Emajack512/stm32-Esp32-Oscilloscope/media/02 Oscilloscope.jpg

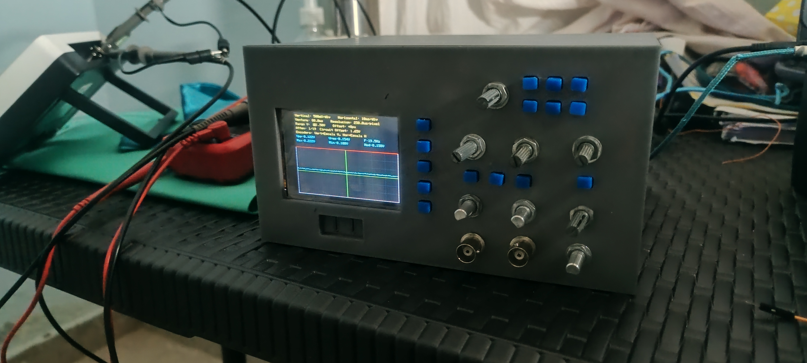
media/02 Oscilloscope.jpg
