Emajack512/stm32-Esp32-Oscilloscope/media/03 Oscilloscope.png

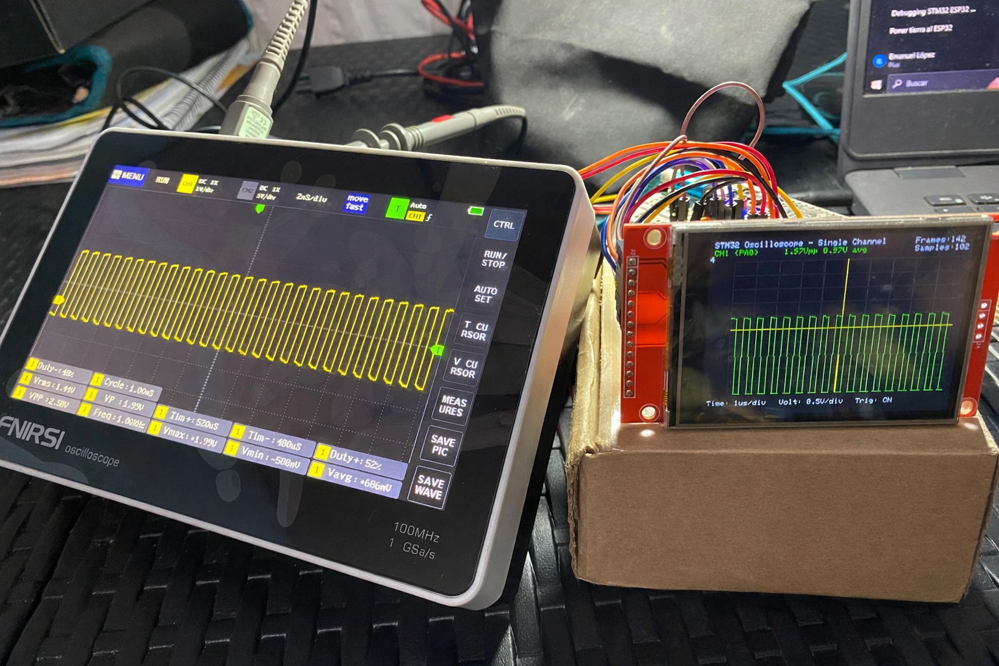
media/03 Oscilloscope.png
