Emajack512/stm32-Esp32-Oscilloscope/hardware/Diagram PCB oscilloscope.png

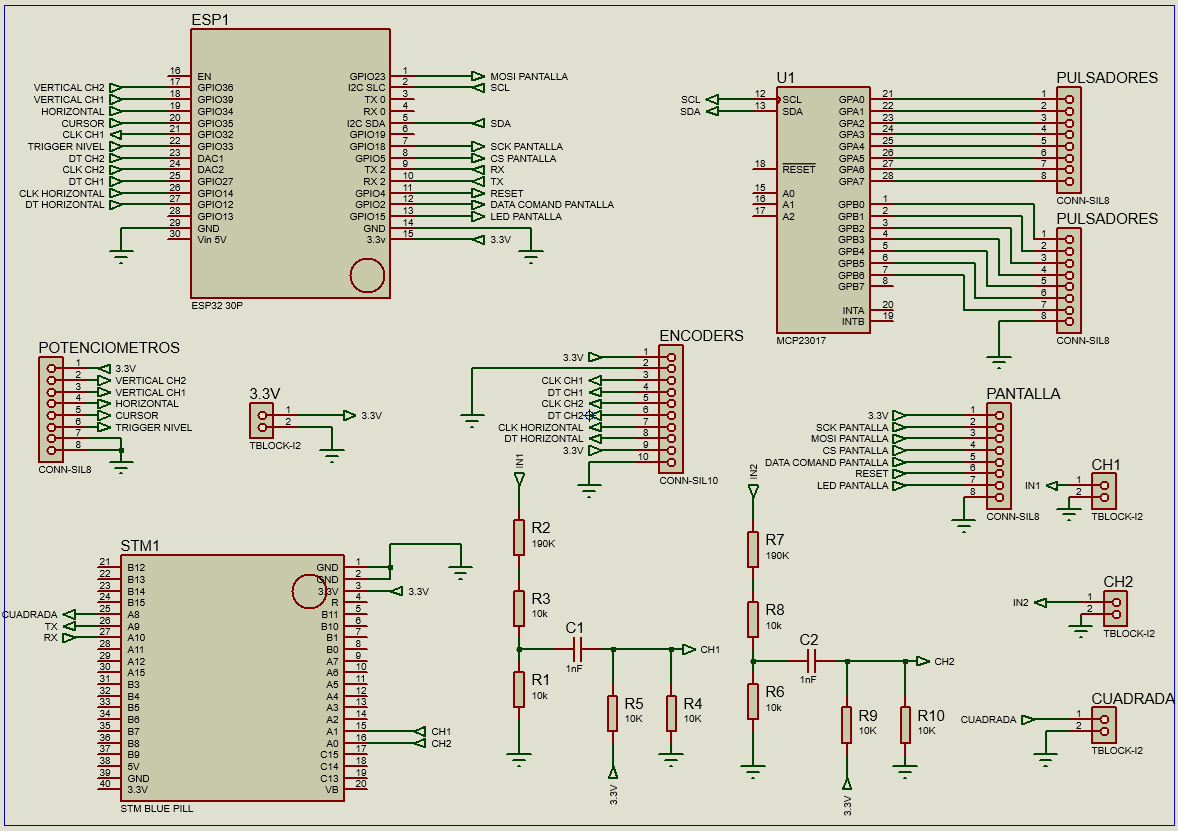
hardware/Diagram PCB oscilloscope.png
