Emajack512/stm32-Esp32-Oscilloscope/hardware/enclosure/01_Render Oscilloscope.png

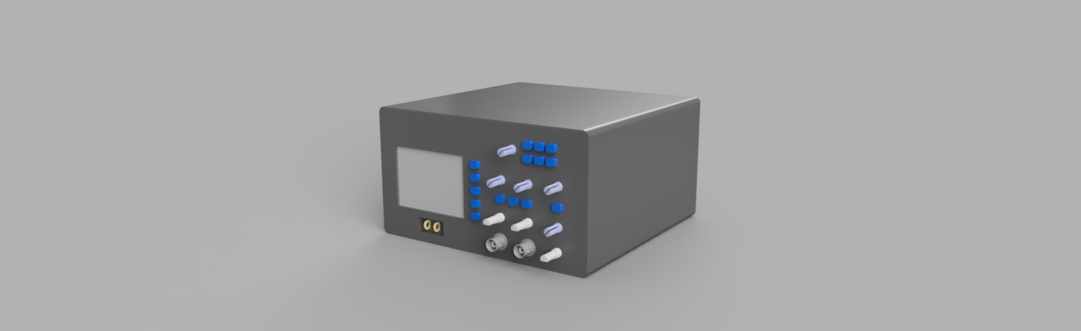
hardware/enclosure/01_Render Oscilloscope.png
