Emajack512/stm32-Esp32-Oscilloscope/hardware/enclosure/02_Render Oscilloscope.png

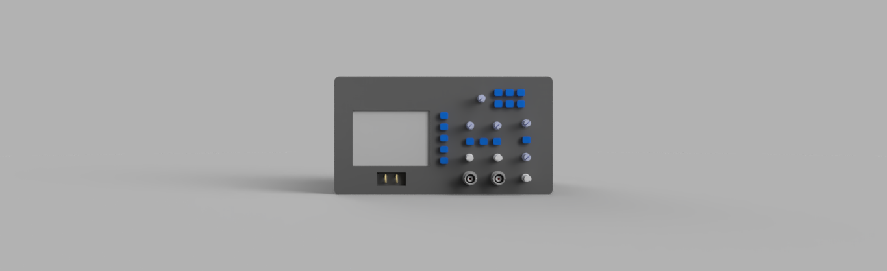
hardware/enclosure/02_Render Oscilloscope.png
