Emajack512/stm32-Esp32-Oscilloscope/hardware/enclosure/03_Render Oscilloscope.png

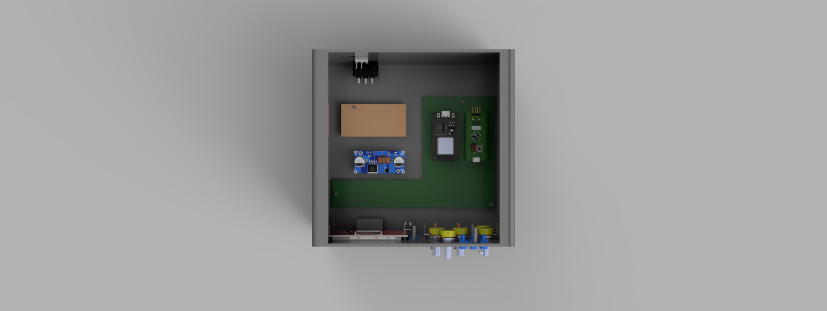
hardware/enclosure/03_Render Oscilloscope.png
