Emajack512/stm32-Esp32-Oscilloscope/hardware/PCB desing Oscilloscope.png

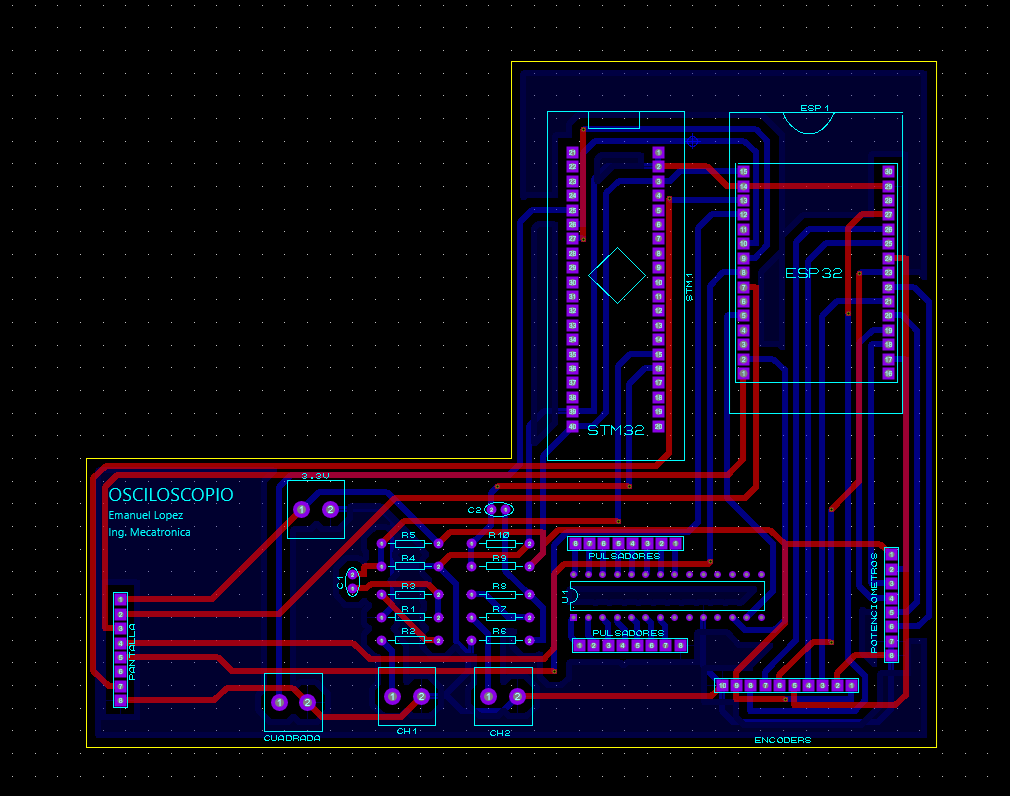
hardware/PCB desing Oscilloscope.png
