Emajack512/stm32-Esp32-Oscilloscope/(list of files, drawings)

Other design files:
hardware/Proteus Desing/Oscilloscope PCB.pdsprj
