Emajack512/stm32-Esp32-Oscilloscope/(commit log)

2026-01-16 Add .gitkeep file to firmware-esp32 directory
2026-01-16 Add oscilloscope photos
    Prototype enclosure + UI screenshots + bench setup
2026-01-16 Add STM32 firmware (20kHz, UART 230400)
2026-01-16 Add ESP32 UI firmware (ILI9341 + encoders, UART230400)
